thomask77/RCMega128/hardware/RCMega128.bmp

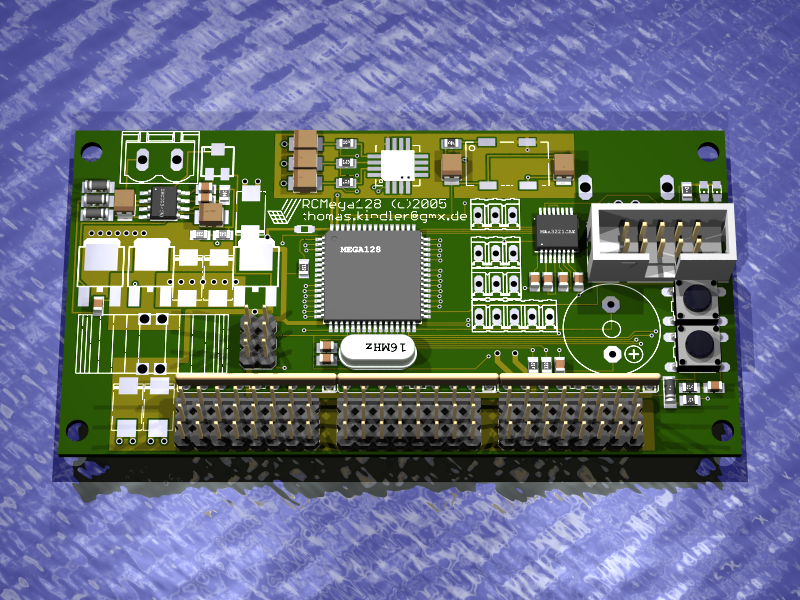
hardware/RCMega128.bmp
