thomask77/RCMega128/README.md

RCMega128
=========

A simple robotic controller board for 24 servo motors
