thomask77/RCMega128/hardware/Wirkungsgrad.xls

120mA für restliche Schaltung.. (schon eingerechnet!)
 | U | I | W | Eff. | U | I | W | Eff. | U | I | W | Eff.
Ausgang | 6.20 | 1.32 | 8.184 |  | 6.15 | 2.42 | 14.883 |  | 6.20 | 7.32 | 45.384
Eingang | 8.00 | 1.10 | 8.8 | 93 | 8.00 | 2.12 | 16.96 | 87.75353774 | 8.00 | 6.58 | 52.64
 | 8.50 | 1.03 | 8.755 | 93.47801256 | 8.50 | 1.99 | 16.915 | 87.98699379 | 8.50 | 6.38 | 54.23 | 83.68799557
 | 9.00 | 0.98 | 8.82 | 92.78911565 | 9.00 | 1.87 | 16.83 | 88.43137255 | 9.00 | 6 | 54 | 84.04444444
 | 9.50 | 0.94 | 8.93 | 91.64613662 | 9.50 | 1.77 | 16.815 | 88.5102587 | 9.50 | 5.72 | 54.34 | 83.51858668
 | 10.00 | 0.89 | 8.9 | 91.95505618 | 10.00 | 1.7 | 17 | 87.54705882 | 10.00 | 5.42 | 54.2 | 83.73431734
 | 10.50 | 0.86 | 9.03 | 90.63122924 | 10.50 | 1.62 | 17.01 | 87.49559083 | 10.50 | 5.07 | 53.235 | 85.25218371
 | 11.00 | 0.83 | 9.13 | 89.63855422 | 11.00 | 1.54 | 16.94 | 87.85714286 | 11.00 | 4.78 | 52.58 | 86.3141879
 | 11.50 | 0.80 | 9.2 | 88.95652174 | 11.50 | 1.48 | 17.02 | 87.44418331 | 11.50 | 4.58 | 52.67 | 86.16669831
 | 12.00 | 0.77 | 9.24 | 88.57142857 | 12.00 | 1.42 | 17.04 | 87.3415493 | 12.00 | 4.33 | 51.96 | 87.34411085
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
