thomask77/RCMega128/hardware/Stückliste.xls

Anzahl | Bezeichnung | Distributor | Best.Nr. | Einzelpreis | Gesamtpreis
2 | IRLR 3717 | Conrad | 164396 - RT | 0.80 € | 1.60 €
1 | IRU 3037CS | Conrad | 163344 - RT | 1.30 € | 1.30 €
1 | IRU 1010-33CD | Conrad | 163241 - RT | 0.73 € | 0.73 €
1 | Piezo-Signalgeber RMP-14P | Conrad | 710131 - RT | 1.08 € | 1.08 €
2 | EPCOS SMD Tantal 220/10 (Schaltfest) | Conrad | 501238 - RT | 2.73 € | 5.46 €
2 | EPCOS SMD Tantal 100/16 (Schaltfest) | Conrad | 501286 - RT | 2.53 € | 5.06 €
1 | SMD Trimmpoti, 5k | Conrad | 421028 - RT | 0.60 € | 0.60 €
1 | Futaba Buchse VE2 | Conrad | 223995 - RT | 1.68 € | 1.68 € | nachbestellen!
1 | Printklemme MKDSN 1,5/2-5,08 | Conrad | 743664 - RT | 0.36 € | 0.36 € | nachbestellen!
1 | MAX 3221E CAE | Reichelt | MAX 3221 ECAE | 2.80 € | 2.80 €
1 | USB-Einbaubuchse, Serie B, gew., Printmontage | Reichelt | USB BW | 0.24 € | 0.24 €
1 | Eisenpulver-Ringkern | Reichelt | T 68-18 | 0.87 € | 0.87 €
1 | ATMega AVR-RISC-Controller, TQFP-64 | Reichelt | ATMEGA 128-16 TQ | 10.50 € | 10.50 €
1 | Standardquarz, Grundton, 16,0 MHz | Reichelt | 16-HC49U-S | 0.44 € | 0.44 €
4 | SMD Diode | Reichelt | SMD 1N 4148 | 0.04 € | 0.16 €
1 | Stiftleiste 2x36 pol. | Reichelt | SL 2X36G 2,54 | 0.25 € | 0.25 €
1 | Stiftleiste 1x36 pol. | Reichelt | SL 1X36G 2,54 | 0.17 € | 0.17 €
3 | Widerstandsarray 8x3k3 | Reichelt | SIL 9-8 3,3K | 0.12 € | 0.36 €
3 | Platinensteckverbinder gerade, braun, 3-polig | Reichelt | PS 25/3G BR | 0.42 € | 1.26 € | passt nicht ins layout!
1 | Platinensteckverbinder gerade, braun, 5-polig | Reichelt | PS 25/5G BR | 0.61 € | 0.61 € | passt nicht ins layout!
2 | SMD Taster | Reichelt | TASTER 1600.11 | 0.64 € | 1.28 €
1 | SMD-Led | Reichelt | SMD-LED 0805 RT | 0.08 € | 0.08 €
1 | SMD-Led | Reichelt | SMD-LED 0805 GN | 0.08 € | 0.08 €
2 | SMD-Widerstand 68 | Reichelt | SMD-0805 68,0 | 0.10 € | 0.20 €
1 | SMD-Widerstand 1k | Reichelt | SMD-0805 1,00K | 0.10 € | 0.10 €
8 | SMD-Widerstand 3k3 | Reichelt | SMD-0805 3,30K | 0.10 € | 0.80 €
4 | SMD-Widerstand 10k | Reichelt | SMD-0805 10,0K | 0.10 € | 0.40 €
1 | SMD-Widerstand 100k | Reichelt | SMD-0805 100K | 0.10 € | 0.10 €
1 | SMD-Induktivität, 10µ | Reichelt | JCI 2012 10µ | 0.25 € | 0.25 €
17 | SMD-Kerko 100n | Reichelt | X7R-G0805 100N | 0.05 € | 0.85 €
2 | SMD-Kondensator 22p | Reichelt | NPO-G0805 22P | 0.05 € | 0.10 €
1 | SMD-Kondensator 680p | Reichelt | NPO-G0805 680P | 0.05 € | 0.05 €
6 | SMD-Tantal 1u/16V | Reichelt | SMD TAN.1,0/16 | 0.36 € | 2.16 €
1 | SMD-Tantal 1u/35V | Reichelt | SMD TAN.1,0/35 | 0.40 € | 0.40 €
1 | SMD-Tantal 100u/6.3V | Reichelt | SMD TAN.100/6,3 | 0.87 € | 0.87 €
1 | GP2D12 Abstandssensor | Conrad | 185309 - RT | 25.54 € | 25.54 €
1 | 3-Axis Acceleration Sensor | Spoerle | MMA7260Q | 13.11 € | 13.11 €
1 | muRata Piezo Gyroscope ENC-03M |  | EN C-03MA -02
1 | PDA-Adapterkabel | Reichelt | NAVILOCK K-61379 | 19.90 € | 19.90 €
1 | Wannenstecker | Reichelt | WSL 10G | 0.07 € | 0.07 €
1 | Pfostenbuchse | Reichelt | PFL 10 | 0.09 € | 0.09 €
 |  |  |  |  | 101.96 €
1 | Kupferlackdraht, Ø 1,0mm, Länge: 6M | Reichelt | KUPFER 1,0MM | 1.55 € | 1.55 €
1 | Flachbandkabel | Reichelt | AWG 28-10F 3M | 2.60 € | 2.60 €
1 | AVR Programming Tool | Reichelt | AT AVR ISP | 39.95 € | 39.95 €
1 | Tamiya Buchse Gold VE5 | Conrad | 223985 - RT | 3.41 € | 3.41 €
1 | Tamiya Stecker Gold VE5 | Conrad | 223983 - RT | 3.41 € | 3.41 €
1 | 1m Silikon-Kabel Rot/Schwarz 2.5mm | Conrad | 223972 - RT | 4.27 € | 4.27 €
1 | Bananenstecker Rot | Conrad | 731356 - RT | 1.03 € | 1.03 €
1 | Bananenstecker Schwarz | Conrad | 731722 - RT | 1.03 € | 1.03 €
1 | Servokabel 5M S/R/W Flach 3 x 0,14 | Conrad | 223967 - RT | 4.27 € | 4.27 €
3 | Futaba Buchse VE2 | Conrad | 223995 - RT | 1.68 € | 1.68 €
1 | 14.7456 MHz Quarz | Segor | Q 14,7456-LP | 1.20 € | 1.20 €
 | Uni-Dortmund Kundennummern
 | * Reichelt: 3104032
 | * Conrad 4087222
